vankubo/STM32_USBAudioCard/readme.md

# STM32F411 USB声卡

* PCB编辑器：KiCAD
* 固件开发：Keil
