vankubo/STM32_USBAudioCard/pcb/usbAudio_kicad_v1/readme.md

## 2021.5

* 初版验证成功

## 2021.6.3

### 第二版

* 增加TPA6138A2耳放
* 电位器封装使用贴片
* 修改USB封装

* 修改LCD为焊接式
* 增加背光控制电路
* 修改耳机孔为直插式

* 电压输入滤波计划更换为钽电容
