vankubo/STM32_USBAudioCard/pcb/usbAudio_kicad_v1/SCH.pdf

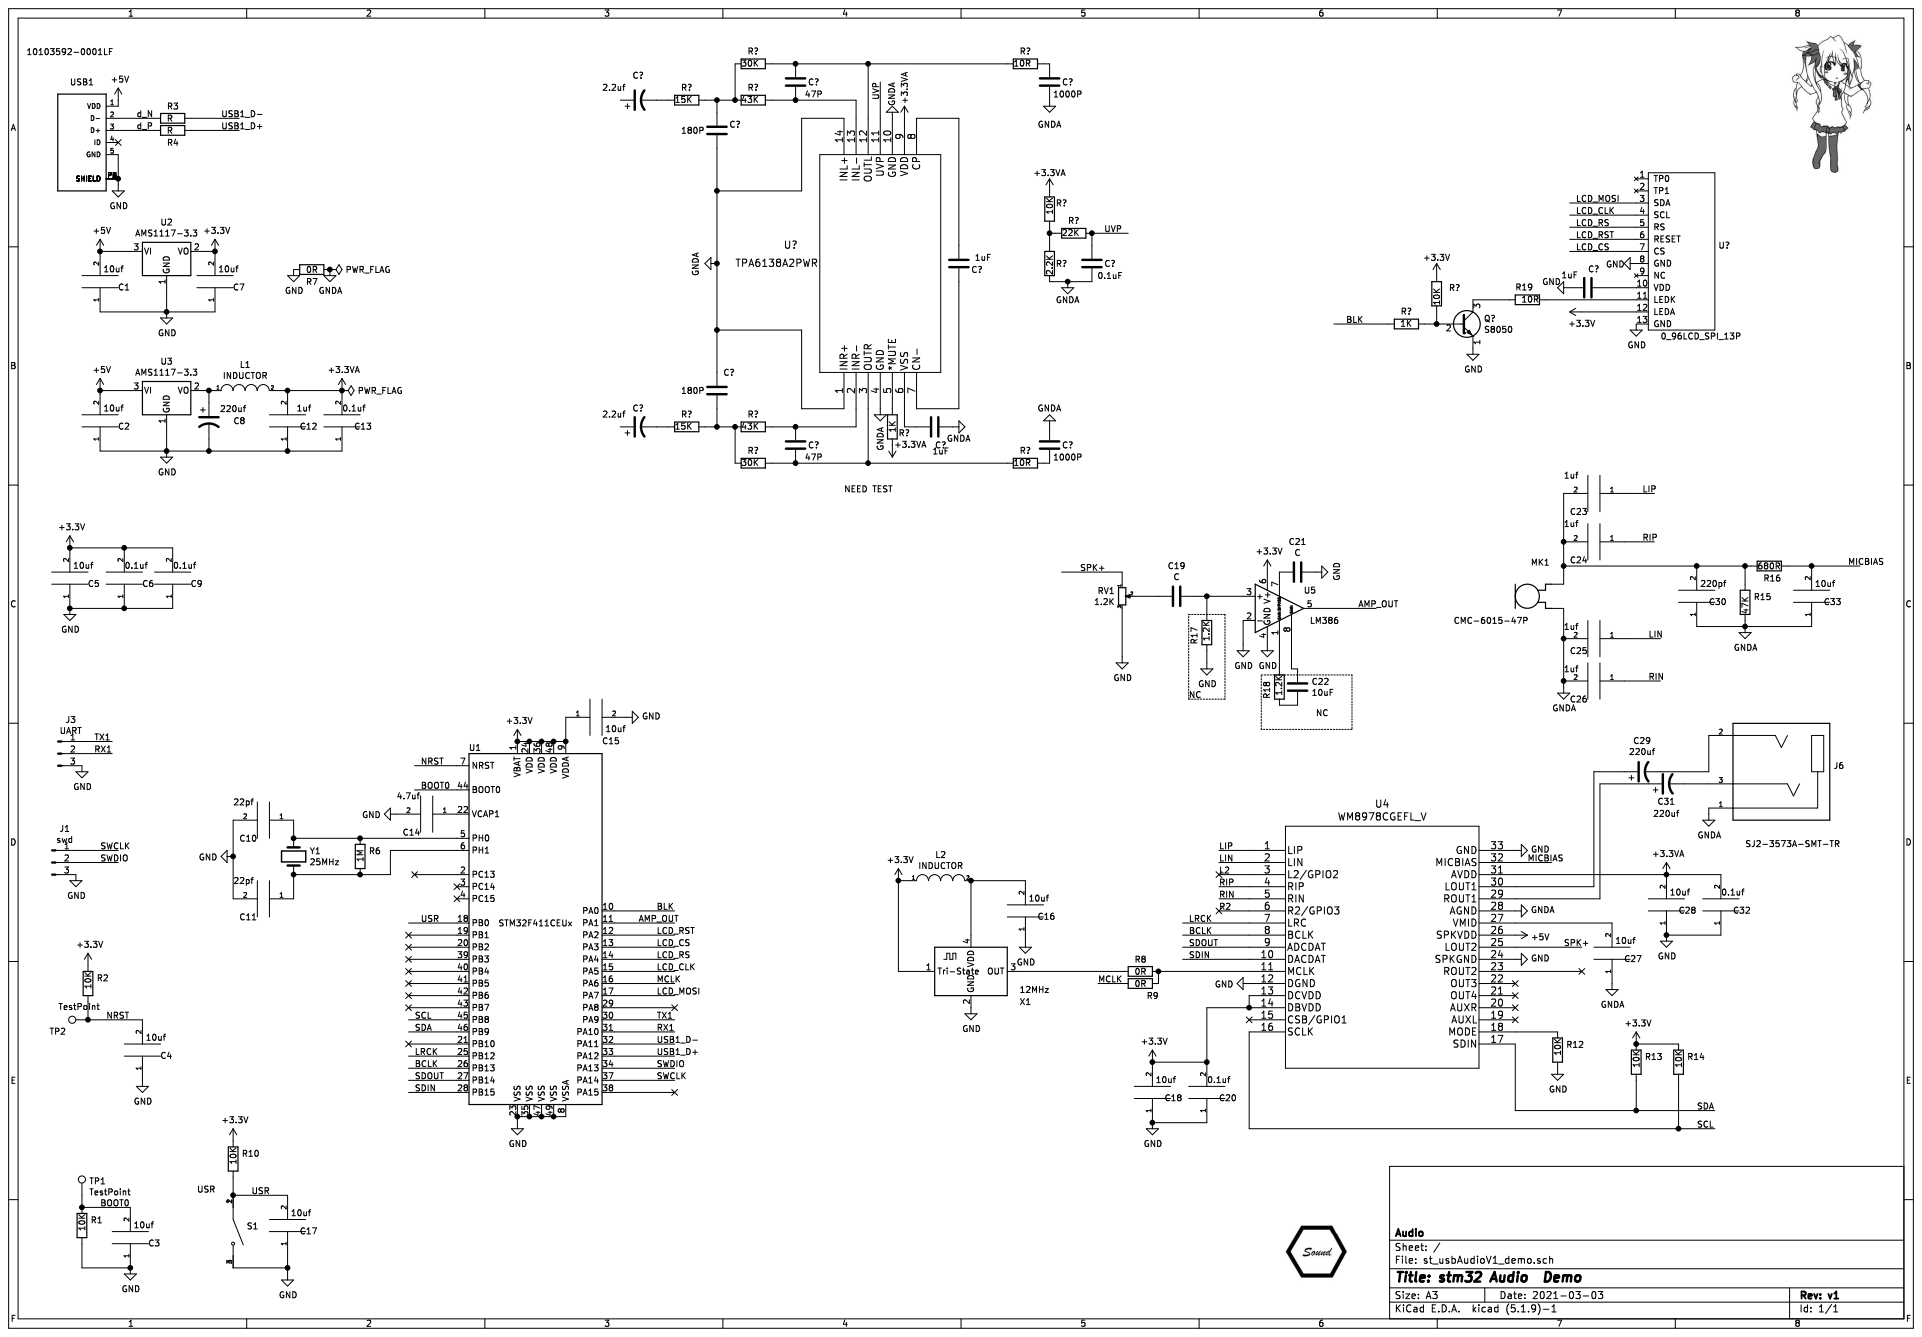
[picture p1: page 1]
