vankubo/STM32_USBAudioCard/(list of files, drawings)

Other design files:
pcb/usbAudio_kicad_v1/PJ313.PCB
pcb/usbAudio_kicad_v1/PJ313D.PCB
