vankubo/STM32_USBAudioCard/pcb/usbAudio_kicad_v1/st_usbAudioV1_demo.kicad_pcb

## KiCad design pcb/usbAudio_kicad_v1/st_usbAudioV1_demo.kicad_pcb (2022-03-26)

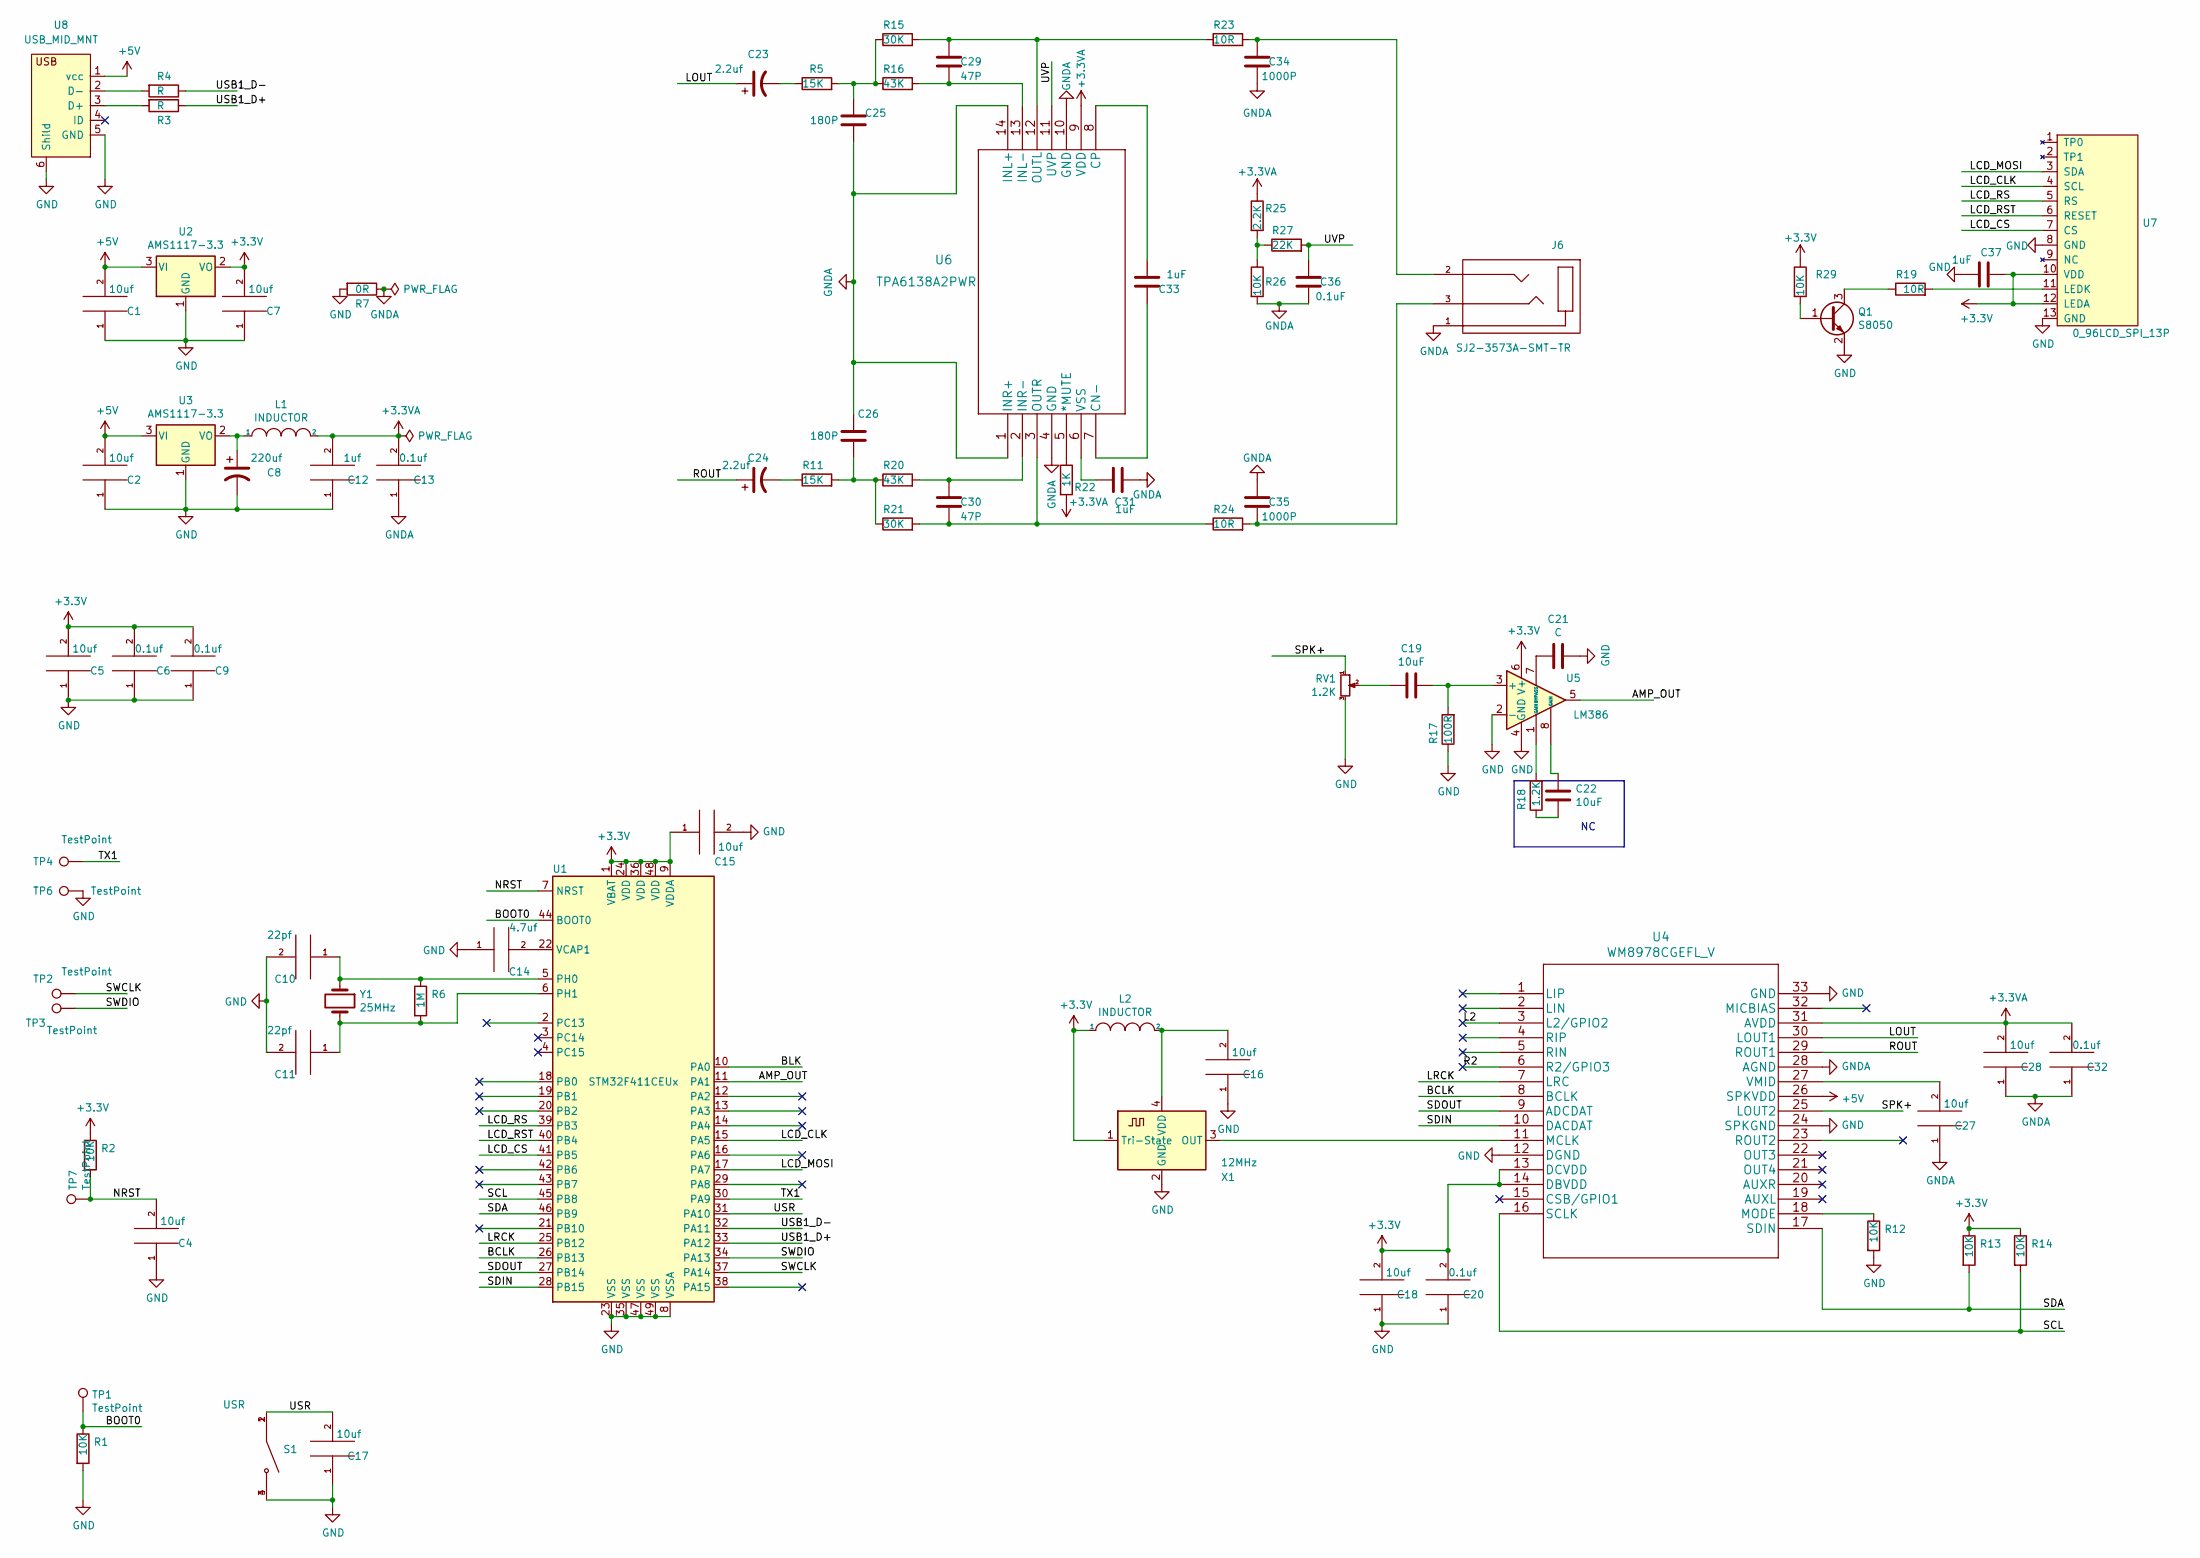
[picture p2: schematic st_usbAudioV1_demo.kicad_sch, stm32 Audio Demo]

Parts:
C1, C2, C4, C5, C7, C15, C16, C17, C18, C27, C28: 10uf; C_0805_2012Metric
C6, C9, C13, C20, C32: 0.1uf; C_0805_2012Metric
C8: 220uf; TAJD107M016RNJ7343
C10, C11: 22pf; C_0805_2012Metric
C12: 1uf; C_0805_2012Metric
C14: 4.7uf; C_0805_2012Metric
C19, C22: 10uF; C_0805_2012Metric
C21: C; C_0805_2012Metric
C23, C24: 2.2uf; TAJD107M016RNJ7343
C25, C26: 180P; C_0805_2012Metric
C29, C30: 47P; C_0805_2012Metric
C31, C33, C37: 1uF; C_0805_2012Metric
C34, C35: 1000P; C_0805_2012Metric
C36: 0.1uF; C_0805_2012Metric
J6: SJ2-3573A-SMT-TR; PJ-313D; PART_REV 1.01
L1: INDUCTOR; L_TDK_NLV32_3.2x2.5mm
L2: INDUCTOR; L_0805_2012Metric
Q1: S8050; SOT-23
R1, R2, R12, R13, R14, R26, R29: 10K; R_0603_1608Metric
R3, R4: R; R_0603_1608Metric
R5, R11: 15K; R_0603_1608Metric
R6: 1M; R_0603_1608Metric
R7: 0R; R_0603_1608Metric
R15, R21: 30K; R_0603_1608Metric
R16, R20: 43K; R_0603_1608Metric
R17: 100R; R_0603_1608Metric
R18: 1.2K; R_0603_1608Metric
R19, R23, R24: 10R; R_0603_1608Metric
R22: 1K; R_0603_1608Metric
R25: 2.2K; R_0603_1608Metric
R27: 22K; R_0603_1608Metric
RV1: 1.2K; Potentiometer_Bourns_TC33X_Vertical
S1: USR; SKQGAKE010
TP1, TP2, TP3, TP4, TP6, TP7: TestPoint; TestPoint_Pad_1.0x1.0mm
U1: STM32F411CEUx; QFN-48-1EP_7x7mm_P0.5mm_EP5.6x5.6mm
U2, U3: AMS1117-3.3; SOT-223-3_TabPin2
U4: WM8978CGEFL_V; WM8978CGEFL
U5: LM386; HSOP-8-1EP_3.9x4.9mm_P1.27mm_EP2.41x3.1mm
U6: TPA6138A2PWR
U7: 0_96LCD_SPI_13P
U8: USB_MID_MNT; MICRO-USB-SMD_MICRO-5P-P0.8_1
X1: 12MHz; Crystal_SMD_3225-4Pin_3.2x2.5mm
Y1: 25MHz; Crystal_SMD_5032-2Pin_5.0x3.2mm

Connections:
+3.3VA: C12.2, C13.2, C28.2, C32.2, L1.2, R22.2, R25.1, U4.31 (AVDD), U6.9 (VDD)
+3V3: C5.2, C6.2, C7.2, C9.2, C15.1, C18.2, C20.2, C37.2, L2.1, R2.1, R13.1, R14.1, R29.1, U1.1 (VBAT), U1.9 (VDDA), U1.24 (VDD), U1.36 (VDD), U1.48 (VDD), U2.2 (VO), U4.13 (DCVDD), U4.14 (DBVDD), U5.6 (V+), U7.10 (VDD), U7.12 (LEDA), X1.1 (Tri-State)
+5V: C1.2, C2.2, U2.3 (VI), U3.3 (VI), U4.26 (SPKVDD), U8.1 (vcc)
/AMP_OUT: U1.11 (PA1), U5.5
/BCLK: U1.26 (PB13), U4.8 (BCLK)
/BLK: U1.10 (PA0)
/BOOT0: R1.1, TP1.1, U1.44 (BOOT0)
/L2: U4.3 (L2/GPIO2)
/LCD_CLK: U1.15 (PA5), U7.4 (SCL)
/LCD_CS: U1.41 (PB5), U7.7 (CS)
/LCD_MOSI: U1.17 (PA7), U7.3 (SDA)
/LCD_RS: U1.39 (PB3), U7.5 (RS)
/LCD_RST: U1.40 (PB4), U7.6 (RESET)
/LOUT: C23.1, U4.30 (LOUT1)
/LRCK: U1.25 (PB12), U4.7 (LRC)
/NRST: C4.2, R2.2, TP7.1, U1.7 (NRST)
/R2: U4.6 (R2/GPIO3)
/ROUT: C24.1, U4.29 (ROUT1)
/SCL: R14.2, U1.45 (PB8), U4.16 (SCLK)
/SDA: R13.2, U1.46 (PB9), U4.17 (SDIN)
/SDIN: U1.28 (PB15), U4.10 (DACDAT)
/SDOUT: U1.27 (PB14), U4.9 (ADCDAT)
/SPK+: RV1.1, U4.25 (LOUT2)
/SWCLK: TP2.1, U1.37 (PA14)
/SWDIO: TP3.1, U1.34 (PA13)
/TX1: TP4.1, U1.30 (PA9)
/USB1_D+: R3.1, U1.33 (PA12)
/USB1_D-: R4.1, U1.32 (PA11)
/USR: C17.2, S1.1, S1.2, U1.31 (PA10)
/UVP: C36.1, R27.2, U6.11 (UVP)
GND: C1.1, C2.1, C4.1, C5.1, C6.1, C7.1, C8.2, C9.1, C10.2, C11.2, C12.1, C14.1, C15.2, C16.1, C17.1, C18.1, C20.1, C21.1, C37.1, Q1.2 (E), R1.2, R7.2, R12.2, R17.1, RV1.3, S1.3, S1.4, TP6.1, U1.8 (VSSA), U1.23 (VSS), U1.35 (VSS), U1.47 (VSS), U1.49 (VSS), U2.1 (GND), U3.1 (GND), U4.12 (DGND), U4.24 (SPKGND), U4.33 (GND), U5.2 (-), U5.4 (GND), U7.8 (GND), U7.13 (GND), U8.5 (GND), U8.6 (Shild), X1.2 (GND)
GNDA: C13.1, C25.2, C26.1, C27.1, C28.1, C31.1, C32.1, C34.2, C35.1, C36.2, J6.1, R7.1, R26.2, U4.28 (AGND), U6.1 (INR+), U6.4 (GND), U6.10 (GND), U6.14 (INL+)
unnamed: C8.1, L1.1, U3.2 (VO)
unnamed: C10.1, R6.1, U1.5 (PH0), Y1.1
unnamed: C11.1, R6.2, U1.6 (PH1), Y1.2
unnamed: C14.2, U1.22 (VCAP1)
unnamed: C16.2, L2.2, X1.4 (VDD)
unnamed: C19.1, R17.2, U5.3 (+)
unnamed: C19.2, RV1.2
unnamed: C21.2, U5.7 (BYPASS)
unnamed: C22.1, U5.8 (GAIN)
unnamed: C22.2, R18.1
unnamed: C23.2, R5.1
unnamed: C24.2, R11.1
unnamed: C25.1, R5.2, R15.1, R16.1
unnamed: C26.2, R11.2, R20.1, R21.1
unnamed: C27.2, U4.27 (VMID)
unnamed: C29.1, R15.2, R23.1, U6.12 (OUTL)
unnamed: C29.2, R16.2, U6.13 (INL-)
unnamed: C30.1, R20.2, U6.2 (INR-)
unnamed: C30.2, R21.2, R24.1, U6.3 (OUTR)
unnamed: C31.2, U6.6 (VSS)
unnamed: C33.1, U6.8 (CP)
unnamed: C33.2, U6.7 (CN-)
unnamed: C34.1, J6.2, R23.2
unnamed: C35.2, J6.3, R24.2
unnamed: Q1.1 (B), R29.2
unnamed: Q1.3 (C), R19.1
unnamed: R3.2, U8.3 (D+)
unnamed: R4.2, U8.2 (D-)
unnamed: R12.1, U4.18 (MODE)
unnamed: R18.2, U5.1 (GAIN)
unnamed: R19.2, U7.11 (LEDK)
unnamed: R22.1, U6.5 (*MUTE)
unnamed: R25.2, R26.1, R27.1
unnamed: U4.11 (MCLK), X1.3 (OUT)

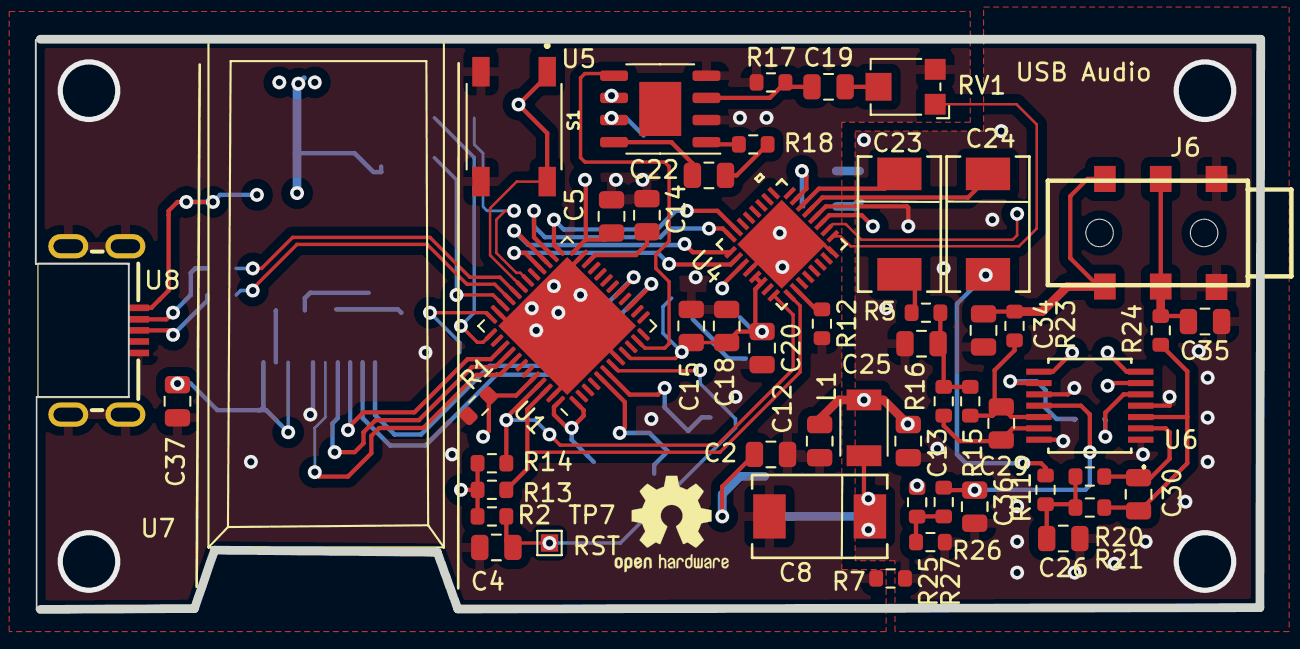
[picture p3: board st_usbAudioV1_demo.kicad_pcb from above]

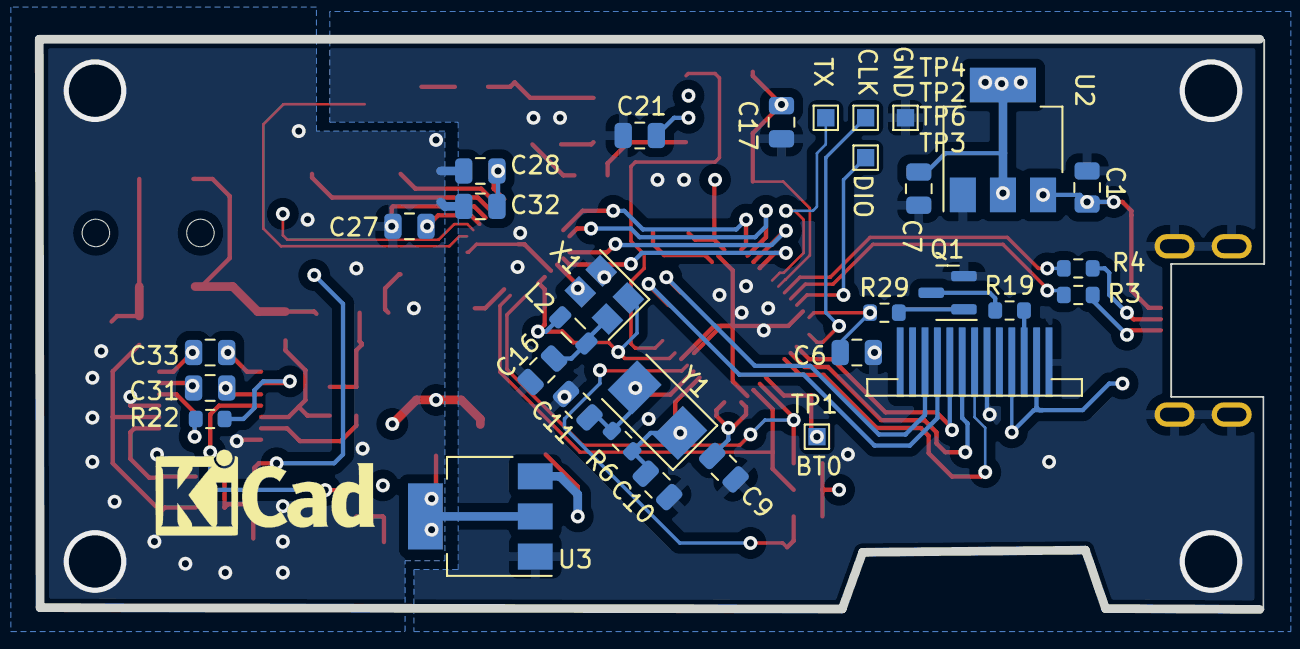
[picture p4: board st_usbAudioV1_demo.kicad_pcb from below]

Board: 4 copper layers, 70.3 x 32.7 mm, 83 parts (31 on the bottom side), 63 nets.
