vankubo/STM32_USBAudioCard/firmware/f411_usbAudio/HARDWARE/SPI/spi.c

#include "spi.h"
//////////////////////////////////////////////////////////////////////////////////	 
 
//SPI 驱动代码	   
//STM32F4工程-库函数版本
//淘宝店铺：http://mcudev.taobao.com									  
////////////////////////////////////////////////////////////////////////////////// 	 


//以下是SPI模块的初始化代码，配置成主机模式 						  
//SPI口初始化
//这里针是对SPI1的初始化
void SPI1_Init(void)
{	 
  GPIO_InitTypeDef  GPIO_InitStructure;
  SPI_InitTypeDef  SPI_InitStructure;
	
  RCC_AHB1PeriphClockCmd(RCC_AHB1Periph_GPIOA, ENABLE);//使能GPIOA时钟
	 RCC_AHB1PeriphClockCmd(RCC_AHB1Periph_GPIOB, ENABLE);//使能GPIOB时钟
  RCC_APB2PeriphClockCmd(RCC_APB2Periph_SPI1, ENABLE);//使能SPI1时钟
 
	GPIO_PinAFConfig(GPIOA,GPIO_PinSource5,GPIO_AF_SPI1); 
	//GPIO_PinAFConfig(GPIOA,GPIO_PinSource6,GPIO_AF_SPI1); 
	GPIO_PinAFConfig(GPIOA,GPIO_PinSource7,GPIO_AF_SPI1); 
	
  //GPIOA5,6,7初始化设置
  GPIO_InitStructure.GPIO_Pin = GPIO_Pin_5|GPIO_Pin_7;//PA5~7复用功能输出	
  GPIO_InitStructure.GPIO_Mode = GPIO_Mode_AF;//复用功能
  GPIO_InitStructure.GPIO_OType = GPIO_OType_PP;//推挽输出
  GPIO_InitStructure.GPIO_Speed = GPIO_Speed_100MHz;//100MHz
  GPIO_InitStructure.GPIO_PuPd = GPIO_PuPd_UP;//上拉
  GPIO_Init(GPIOA, &GPIO_InitStructure);//初始化
	
	//初始化片选引脚
	GPIO_InitStructure.GPIO_Pin = GPIO_Pin_5;//PB5
  GPIO_InitStructure.GPIO_Mode = GPIO_Mode_OUT;//输出功能
  GPIO_InitStructure.GPIO_OType = GPIO_OType_PP;//推挽输出
  GPIO_InitStructure.GPIO_Speed = GPIO_Speed_100MHz;//100MHz
  GPIO_InitStructure.GPIO_PuPd = GPIO_PuPd_UP;//上拉
  GPIO_Init(GPIOB, &GPIO_InitStructure);//初始化
	GPIO_SetBits(GPIOB,GPIO_Pin_5);
 
 

	//这里只针对SPI口初始化
	RCC_APB2PeriphResetCmd(RCC_APB2Periph_SPI1,ENABLE);//复位SPI1
	RCC_APB2PeriphResetCmd(RCC_APB2Periph_SPI1,DISABLE);//停止复位SPI1

	SPI_InitStructure.SPI_Direction = SPI_Direction_1Line_Tx;  //设置SPI单向或者双向的数据模式:SPI设置为双线双向全双工
	SPI_InitStructure.SPI_Mode = SPI_Mode_Master;		//设置SPI工作模式:设置为主SPI
	SPI_InitStructure.SPI_DataSize = SPI_DataSize_8b;		//设置SPI的数据大小:SPI发送接收8位帧结构
	SPI_InitStructure.SPI_CPOL = SPI_CPOL_High;		//串行同步时钟的空闲状态为高电平
	SPI_InitStructure.SPI_CPHA = SPI_CPHA_2Edge;	//串行同步时钟的第二个跳变沿（上升或下降）数据被采样
	SPI_InitStructure.SPI_NSS = SPI_NSS_Soft;		//NSS信号由硬件（NSS管脚）还是软件（使用SSI位）管理:内部NSS信号有SSI位控制
	SPI_InitStructure.SPI_BaudRatePrescaler = SPI_BaudRatePrescaler_128;		//定义波特率预分频的值:波特率预分频值为256
	SPI_InitStructure.SPI_FirstBit = SPI_FirstBit_MSB;	//指定数据传输从MSB位还是LSB位开始:数据传输从MSB位开始
	SPI_InitStructure.SPI_CRCPolynomial = 7;	//CRC值计算的多项式
	SPI_Init(SPI1, &SPI_InitStructure);  //根据SPI_InitStruct中指定的参数初始化外设SPIx寄存器
 

	SPI_Cmd(SPI1, ENABLE); //使能SPI外设
	SPI1_ReadWriteByte(0xff);//启动传输	
	
}   
//SPI1速度设置函数 @ref SPI_BaudRate_Prescaler
//SPI速度=fAPB2/2^(SpeedSet+1)
//fAPB2时钟一般为84Mhz
void SPI1_SetSpeed(u8 SPI_BaudRatePrescaler)
{
  assert_param(IS_SPI_BAUDRATE_PRESCALER(SPI_BaudRatePrescaler));//判断有效性
	SPI1->CR1&=0XFFC7;//位3-5清零，用来设置波特率
	SPI1->CR1|=SPI_BaudRatePrescaler;	//设置SPI1速度 
	SPI_Cmd(SPI1,ENABLE); //使能SPI1
} 
//SPI1 读写一个字节
//TxData:要写入的字节
//返回值:读取到的字节
u8 SPI1_ReadWriteByte(u8 TxData)
{		 			 
 
  while (SPI_I2S_GetFlagStatus(SPI1, SPI_I2S_FLAG_TXE) == RESET){}//等待发送区空  
	SPI_I2S_SendData(SPI1, TxData); //通过外设SPIx发送一个byte  数据
	
  //while (SPI_I2S_GetFlagStatus(SPI1, SPI_I2S_FLAG_RXNE) == RESET){} //等待接收完一个byte  
	//return SPI_I2S_ReceiveData(SPI1); //返回通过SPIx最近接收的数据	
 	return 0;   
}


//SPI1 读写2byte
//TxData:要写入的字节
//返回值:读取到的字节
u8 SPI1_ReadWriteByte16(u16 TxData)
{		 			 
 
  while (SPI_I2S_GetFlagStatus(SPI1, SPI_I2S_FLAG_TXE) == RESET){}//等待发送区空  
	SPI_I2S_SendData(SPI1, TxData); //通过外设SPIx发送一个byte  数据
	
  //while (SPI_I2S_GetFlagStatus(SPI1, SPI_I2S_FLAG_RXNE) == RESET){} //等待接收完一个byte  
	//return SPI_I2S_ReceiveData(SPI1); //返回通过SPIx最近接收的数据	
 	return 0;   
}
/*
设置SPI数据宽度
SPI_DataSize_16b
SPI_DataSize_8b
*/

void SPI1_setDataSize(uint16_t SPI_DataSize)
{
	SPI_DataSizeConfig(SPI1, SPI_DataSize);
}

//片选引脚
void SPI1_CS(u8 cs)
{
	if(cs==0)
		GPIO_ResetBits(GPIOB,GPIO_Pin_5);
		
	else
		GPIO_SetBits(GPIOB,GPIO_Pin_5);
}



u8 SPI1_sendData(u16 data)
{
	SPI1_CS(0);
	while (SPI_I2S_GetFlagStatus(SPI1, SPI_I2S_FLAG_TXE) == RESET){};//等待发送区空  
	SPI_I2S_SendData(SPI1, data); //通过外设SPIx发送一个byte  数据
	while (SPI_I2S_GetFlagStatus(SPI1, SPI_I2S_FLAG_BSY) == SET){};//等待发送完成
	SPI1_CS(1);
}
