vankubo/STM32_USBAudioCard/firmware/f411_usbAudio/HARDWARE/ADC/adc.h

#ifndef __ADC_H
#define __ADC_H	
#include "sys.h" 
//////////////////////////////////////////////////////////////////////////////////	 
 
//ADC 驱动代码	   
//STM32F4工程-库函数版本
//淘宝店铺：http://mcudev.taobao.com								  
////////////////////////////////////////////////////////////////////////////////// 	 
 							   
void Adc_Init(void); 				//ADC通道初始化
u16  Get_Adc(u8 ch); 				//获得某个通道值 
u16 Get_Adc_Average(u8 ch,u8 times);//得到某个通道给定次数采样的平均值  


#endif 
