vankubo/STM32_USBAudioCard/firmware/f411_usbAudio/HARDWARE/KEY/key.c

#include "key.h"
#include "delay.h" 
#include "stdio.h"
//////////////////////////////////////////////////////////////////////////////////	 
uint8_t key=0;
 
 
//按键输入驱动代码	   
//STM32F4工程-库函数版本
//淘宝店铺：http://mcudev.taobao.com								  
////////////////////////////////////////////////////////////////////////////////// 	 

//按键初始化函数
void KEY_Init(void)
{
	
	GPIO_InitTypeDef  GPIO_InitStructure;

  RCC_AHB1PeriphClockCmd(RCC_AHB1Periph_GPIOA, ENABLE);//使能GPIOA时钟
 
  GPIO_InitStructure.GPIO_Pin = GPIO_Pin_10; //PA10
  GPIO_InitStructure.GPIO_Mode = GPIO_Mode_IN;//普通输入模式
  GPIO_InitStructure.GPIO_Speed = GPIO_Speed_100MHz;//100M
  GPIO_InitStructure.GPIO_PuPd = GPIO_PuPd_UP;//上拉
  GPIO_Init(GPIOA, &GPIO_InitStructure);//初始化GPIOA10

} 

void KEY_EXTI_Init(void)
{
	NVIC_InitTypeDef   NVIC_InitStructure;
	EXTI_InitTypeDef   EXTI_InitStructure;
	
	KEY_Init(); //按键对应的IO口初始化
 
	RCC_APB2PeriphClockCmd(RCC_APB2Periph_SYSCFG, ENABLE);//使能SYSCFG时钟
	
 
	SYSCFG_EXTILineConfig(EXTI_PortSourceGPIOA, EXTI_PinSource10);//PA10 连接到中断线10
	
  /* 配置EXTI_Line0 */
  EXTI_InitStructure.EXTI_Line = EXTI_Line10;//LINE0
  EXTI_InitStructure.EXTI_Mode = EXTI_Mode_Interrupt;//中断事件
  EXTI_InitStructure.EXTI_Trigger = EXTI_Trigger_Falling; //上升沿触发 
  EXTI_InitStructure.EXTI_LineCmd = ENABLE;//使能LINE0
  EXTI_Init(&EXTI_InitStructure);//配置
	
	
 
	NVIC_InitStructure.NVIC_IRQChannel = EXTI15_10_IRQn;//外部中断
  NVIC_InitStructure.NVIC_IRQChannelPreemptionPriority = 0x00;//抢占优先级0
  NVIC_InitStructure.NVIC_IRQChannelSubPriority = 0x02;//子优先级2
  NVIC_InitStructure.NVIC_IRQChannelCmd = ENABLE;//使能外部中断通道
  NVIC_Init(&NVIC_InitStructure);//配置
	
	   
}



//外部中断0服务程序
void EXTI15_10_IRQHandler(void)
{
	key=1;
	delay_ms(10);
	EXTI_ClearITPendingBit(EXTI_Line10); //清除LINE0上的中断标志位 
	
}	
