vankubo/STM32_USBAudioCard/firmware/f411_usbAudio/HARDWARE/LED/led.c

#include "led.h" 
//////////////////////////////////////////////////////////////////////////////////	 
 
//LED驱动代码	   
//STM32F4工程-库函数版本
//淘宝店铺：http://mcudev.taobao.com									  
////////////////////////////////////////////////////////////////////////////////// 	 

//初始化PC13	    
//LED IO初始化
void LED_Init(void)
{    	 
  GPIO_InitTypeDef  GPIO_InitStructure;

  RCC_AHB1PeriphClockCmd(RCC_AHB1Periph_GPIOC, ENABLE);//使能GPIOC时钟

  //GPIOC13初始化设置
  GPIO_InitStructure.GPIO_Pin = GPIO_Pin_13;
  GPIO_InitStructure.GPIO_Mode = GPIO_Mode_OUT;//普通输出模式
  GPIO_InitStructure.GPIO_OType = GPIO_OType_PP;//推挽输出
  GPIO_InitStructure.GPIO_Speed = GPIO_Speed_100MHz;//100MHz
  GPIO_InitStructure.GPIO_PuPd = GPIO_PuPd_UP;//上拉
  GPIO_Init(GPIOC, &GPIO_InitStructure);//初始化
	
	GPIO_SetBits(GPIOC,GPIO_Pin_13);//GPIOC13设置高，灯灭

}
