vankubo/STM32_USBAudioCard/firmware/f411_usbAudio/HARDWARE/LED/led.h

#ifndef __LED_H
#define __LED_H
#include "sys.h"

//////////////////////////////////////////////////////////////////////////////////	 
 
//LED驱动代码	   
//STM32F4工程-库函数版本
//淘宝店铺：http://mcudev.taobao.com									  
////////////////////////////////////////////////////////////////////////////////// 	


//LED端口定义
#define LED0 PCout(13)	//  

void LED_Init(void);//初始化		 				    
#endif
