vankubo/STM32_USBAudioCard/firmware/f411_usbAudio/HARDWARE/SPI/spi.h

#ifndef __SPI_H
#define __SPI_H
#include "sys.h"
//////////////////////////////////////////////////////////////////////////////////	 
 
//SPI 驱动代码	   
//STM32F4工程-库函数版本
//淘宝店铺：http://mcudev.taobao.com										  
////////////////////////////////////////////////////////////////////////////////// 	

/*
SPI1
CLK-PA5
MISO
MOSI-PA7
NSS-PA4
*/
 
						  	    													  
void SPI1_Init(void);			 //初始化SPI1口
void SPI1_SetSpeed(u8 SpeedSet); //设置SPI1速度   
u8 SPI1_ReadWriteByte(u8 TxData);//SPI1总线读写一个字节
void SPI1_CS(u8 cs);	
u8 SPI1_sendData(u16 data);
void SPI1_setDataSize(uint16_t SPI_DataSize);
#endif
