vankubo/STM32_USBAudioCard/firmware/f411_usbAudio/HARDWARE/framebuffer/framebuffer.h

#ifndef __FRAMEBUFFER_H
#define __FRAMEBUFFER_H
#include "sys.h"
#include "spi.h"
#include "lcd_Driver.h"
#include "dma.h"

/*
像素位数默认16bit
*/

//显存像素数
#define FRAMEBUFFER_SIZE 12800
#define PIXEL_SIZE 2



typedef struct 
{
	u16 *buffer;//显存指针
	u32 height;//高度
	u32 width;//宽度
	u8 buffer_fresh;//显存更新标志
}framebuffer_typedef;


void framebuffer_init(framebuffer_typedef *framebuf,u32 width,u32 height);
void framebuffer_dump(framebuffer_typedef *framebuf,u16 x_start,u16 y_start,u16 x_end,u16 y_end);
void framebuffet_clear(framebuffer_typedef *framebuf,u16 color);
#endif
