vankubo/STM32_USBAudioCard/firmware/f411_usbAudio/HARDWARE/OLED/olediic.c

#include "olediic.h"
#include "delay.h"
//////////////////////////////////////////////////////////////////////////////////	 
 
//IIC 驱动代码	   
//STM32F4工程-库函数版本
//淘宝店铺：http://mcudev.taobao.com								  
////////////////////////////////////////////////////////////////////////////////// 	

//初始化IIC
void OLEDIIC_Init(void)
{			
  GPIO_InitTypeDef  GPIO_InitStructure;

  RCC_AHB1PeriphClockCmd(RCC_AHB1Periph_GPIOA, ENABLE);//使能GPIOB时钟

  //GPIOB8,B9初始化设置
  GPIO_InitStructure.GPIO_Pin = GPIO_Pin_2 | GPIO_Pin_3;
  GPIO_InitStructure.GPIO_Mode = GPIO_Mode_OUT;//普通输出模式
  GPIO_InitStructure.GPIO_OType = GPIO_OType_PP;//推挽输出
  GPIO_InitStructure.GPIO_Speed = GPIO_Speed_100MHz;//100MHz
  GPIO_InitStructure.GPIO_PuPd = GPIO_PuPd_UP;//上拉
  GPIO_Init(GPIOA, &GPIO_InitStructure);//初始化
	OIIC_SCL=1;
	OIIC_SDA=1;
}
//产生IIC起始信号
void OLEDIIC_Start(void)
{
	OLEDSDA_OUT();     //sda线输出
	OIIC_SDA=1;	  	  
	OIIC_SCL=1;
	delay_us(4);
 	OIIC_SDA=0;//START:when CLK is high,DATA change form high to low 
	delay_us(4);
	OIIC_SCL=0;//钳住I2C总线，准备发送或接收数据 
}	  
//产生IIC停止信号
void OLEDIIC_Stop(void)
{
	OLEDSDA_OUT();//sda线输出
	OIIC_SCL=0;
	OIIC_SDA=0;//STOP:when CLK is high DATA change form low to high
 	delay_us(4);
	OIIC_SCL=1; 
	OIIC_SDA=1;//发送I2C总线结束信号
	delay_us(4);							   	
}
//等待应答信号到来
//返回值：1，接收应答失败
//        0，接收应答成功
u8 OLEDIIC_Wait_Ack(void)
{
	u8 ucErrTime=0;
	OLEDSDA_IN();      //SDA设置为输入  
	OIIC_SDA=1;delay_us(1);	   
	OIIC_SCL=1;delay_us(1);	 
	while(OREAD_SDA)
	{
		ucErrTime++;
		if(ucErrTime>250)
		{
			OLEDIIC_Stop();
			return 1;
		}
	}
	OIIC_SCL=0;//时钟输出0 	   
	return 0;  
} 
//产生ACK应答
void OLEDIIC_Ack(void)
{
	OIIC_SCL=0;
	OLEDSDA_OUT();
	OIIC_SDA=0;
	delay_us(2);
	OIIC_SCL=1;
	delay_us(2);
	OIIC_SCL=0;
}
//不产生ACK应答		    
void OLEDIIC_NAck(void)
{
	OIIC_SCL=0;
	OLEDSDA_OUT();
	OIIC_SDA=1;
	delay_us(2);
	OIIC_SCL=1;
	delay_us(2);
	OIIC_SCL=0;
}					 				     
//IIC发送一个字节
//返回从机有无应答
//1，有应答
//0，无应答			  
void OLEDIIC_Send_Byte(u8 txd)
{                        
    u8 t;   
	OLEDSDA_OUT(); 	    
    OIIC_SCL=0;//拉低时钟开始数据传输
    for(t=0;t<8;t++)
    {              
        OIIC_SDA=(txd&0x80)>>7;
        txd<<=1; 	  
		delay_us(2);   //对TEA5767这三个延时都是必须的
		OIIC_SCL=1;
		delay_us(2); 
		OIIC_SCL=0;	
		delay_us(2);
    }	 
} 	    
//读1个字节，ack=1时，发送ACK，ack=0，发送nACK   
u8 OLEDIIC_Read_Byte(unsigned char ack)
{
	unsigned char i,receive=0;
	OLEDSDA_IN();//SDA设置为输入
    for(i=0;i<8;i++ )
	{
        OIIC_SCL=0; 
        delay_us(2);
		OIIC_SCL=1;
        receive<<=1;
        if(OREAD_SDA)receive++;   
		delay_us(1); 
    }					 
    if (!ack)
        OLEDIIC_NAck();//发送nACK
    else
        OLEDIIC_Ack(); //发送ACK   
    return receive;
}
